Dropeffect/XG-Hotend/README.md

# Dropeffect GitHub
Welcome to the Dropeffect GitHub repository. This is a place to share the instructions, models, adapters and any other relevant files for the Dropeffect products from Dropeffect R&D team and other users. 

Check the folders under the product name to find the file you need. We will continue updating the folders.

# How to buy Dropeffect products
Check the reseller list from Dropeffect website: www.dropeffect.com/pages/resellers

# Note
Thank you for using Dropeffect products. If you have any questions during use, please do not hesitate to contact us: contact@dropeffect.com. We will work with you to solve it. 

For more product information you can always follow Dropeffect Website/Twitter/Instagram/Facebook/Youtube and GitHub. Thank you!

Dropeffect Website: www.dropeffect.com

Dropeffect Twitter: www.twitter.com/dropeffect

Dropeffect Instagram: www.instagram.com/drop_effect

Dropeffect Facebook: www.facebook.com/Dropeffect

Dropeffect Youtube: www.youtube.com/@DropEffect

# Youtube link
Detailed introduction video: www.youtube.com/watch?v=byz4_2zUmTg

# Disclaimers
All models are shared for personal use only and commercial use is prohibited.

Models reuploaded base on original author's statement.
