Dropeffect/XG-Hotend/Product Adaptor Models/XG Hotend CR Mount.step

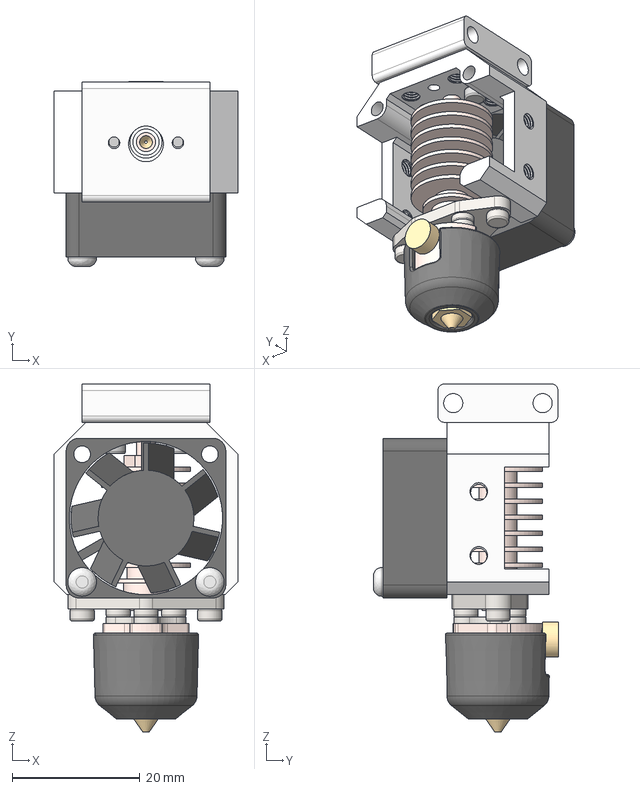
[picture p3: CAD file, 2023-06-26]
Product Adaptor Models/XG Hotend CR Mount.step
28.8 x 29.0 x 54.5 mm
Ring Heater Cu
Heatsink Cu
Frame Al
2510 Fan
ISO 7380 M2.5x14 SS
Nozzle
DIN 912 M2x6 SS (1)
Creality Mount Al
Silicone Sock
Thermistor
Heatbreak
