Dropeffect/XG-Hotend/Product Wireframes/XG wireframe-corrections.pdf

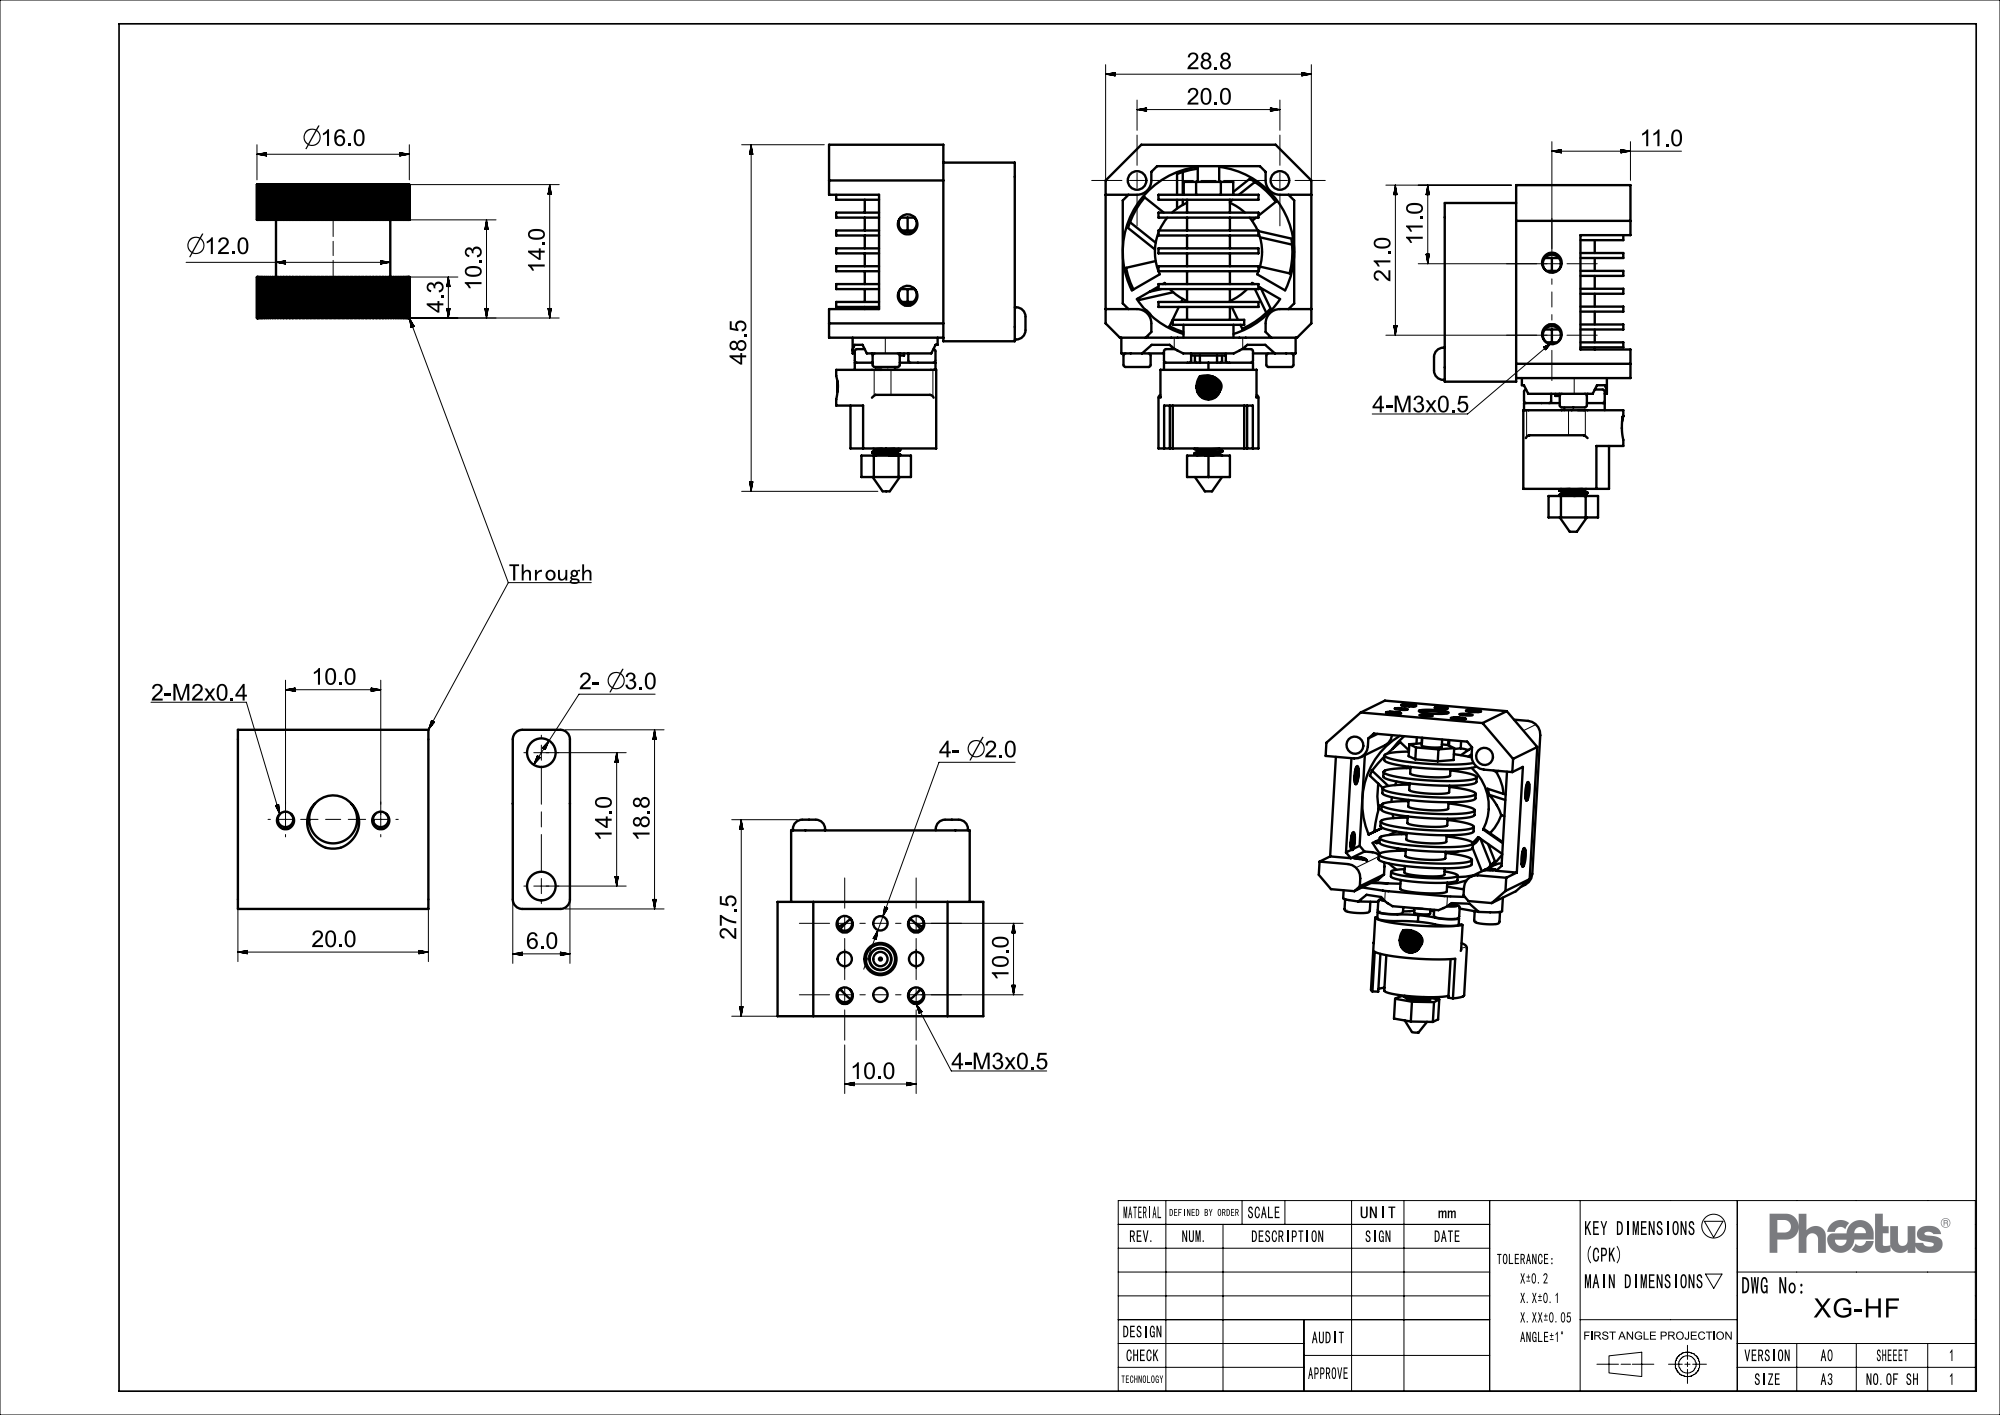
[picture p4: page 1]
